manuelaceron/closed-loop-FDM-printer/docs/Sustentacio_Manuela Cerón.pdf

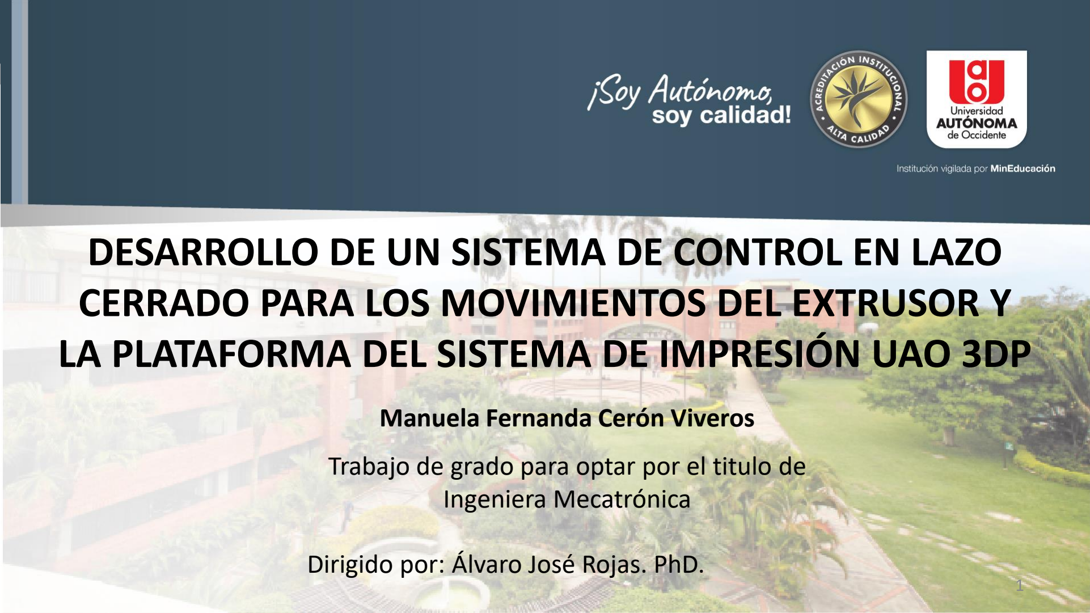
[picture p17: page 1]

# DESARROLLO DE UN SISTEMA DE CONTROL EN LAZO CERRADO PARA LOS MOVIMIENTOS DEL EXTRUSOR Y LA PLATAFORMA DEL SISTEMA DE IMPRESIÓN UAO 3DP

# Manuela Fernanda Cerón Viveros

# Trabajo de grado para optar por el titulo de Ingeniera Mecatrónica

Dirigido por: Álvaro José Rojas. PhD.

# MARCO TEORICO

# › IMPRESIÓN 3D

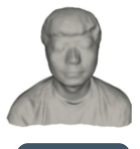
[picture p18: figure]
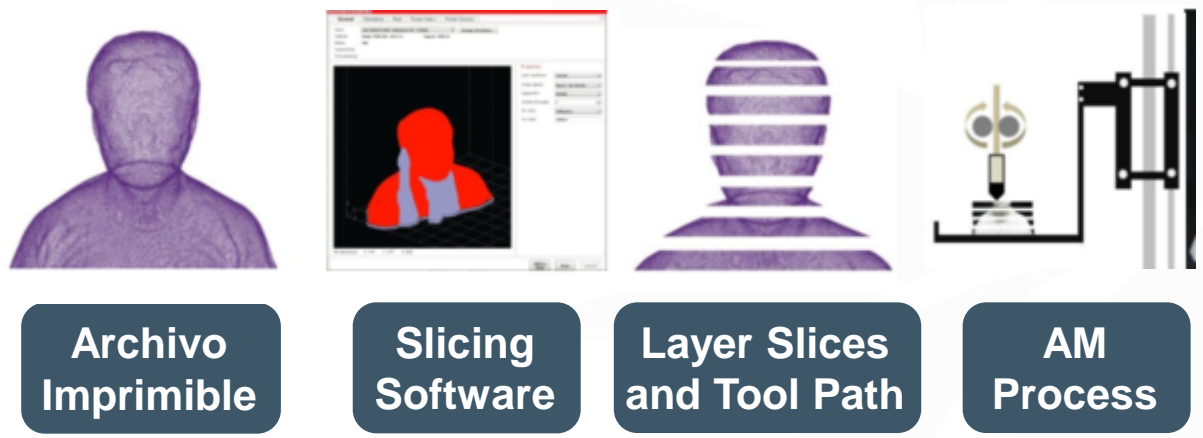
[picture p19: figure]
Slicing Software; Layer Slices and Tool Path; AM Process; Archivo Imprimible

## 3D CAD Model

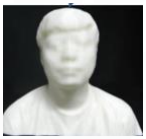
[picture p20: figure]

## Physical 3D Object

Fotopolimerización | Extrusión de material

# Fusión de cama de polvo

# › TECNOLOGÍAS DE IMPRESIÓN 3D

# Inyección de material Inyección de aglutinante

# Deposición de

energía directa | Laminado

Fuente: REDWOOD, Ben. Additive Manufacturing Technologies: An Overview [En línea]. 3D HUBS. [Consultado el 29 de Marzo del 2018]. Disponible en internet: https://www.3dhubs.com/knowledge-base/additive-manufacturing-technologies-overview

# › SISTEMA DE CONTROL

# Lazo de Control Abierto

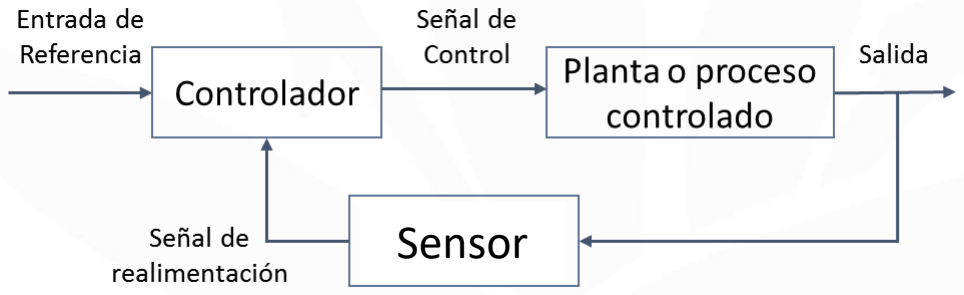
[picture p21: figure]
Sensor

# Lazo de Control Cerrado

# › SENSORES DE POSICIÓN

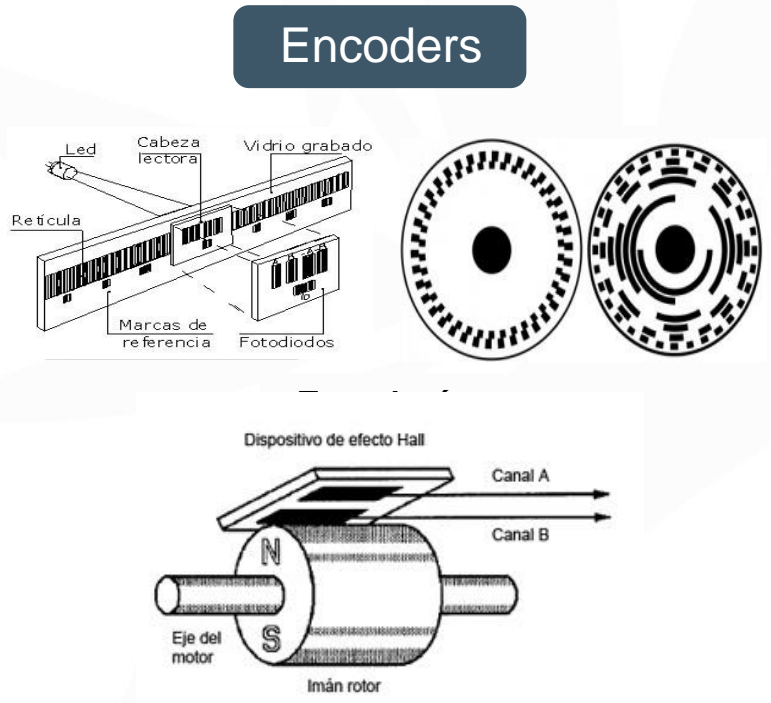
[picture p22: figure]
Arquitectura; › Lineal › Rotacional; Tecnología; › Magnético › Óptico; › Inductivo; Tipo; › Incremental › Absoluto

Resistivos | Inductivos | Encoders

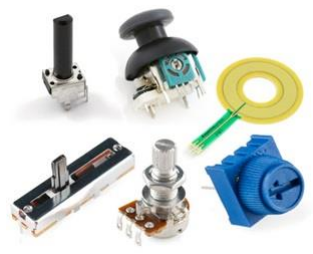
[picture p23: figure]

## › Resolver › LVDT › RVDT

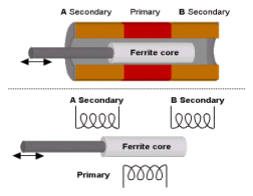
[picture p24: figure]

# › IMPRESORA UAO 3DP

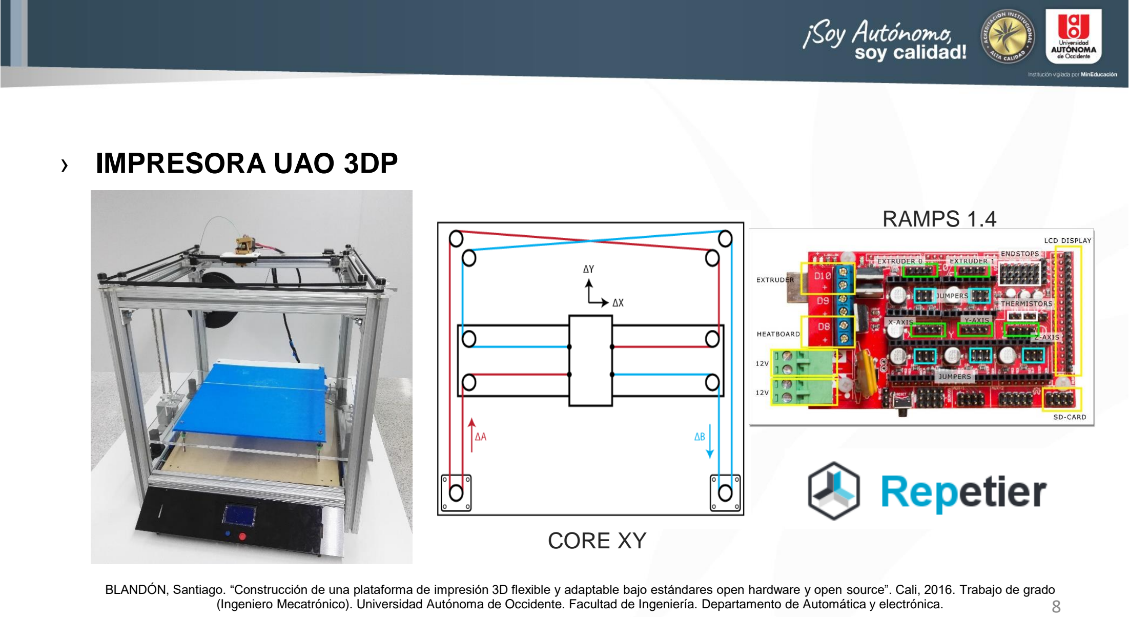
[picture p25: page 6]

BLANDÓN, Santiago. “Construcción de una plataforma de impresión 3D flexible y adaptable bajo estándares open hardware y open source”. Cali, 2016. Trabajo de grado (Ingeniero Mecatrónico). Universidad Autónoma de Occidente. Facultad de Ingeniería. Departamento de Automática y electrónica.

## RAMPS 1.4

## CORE XY

# PLANTEAMIENTO DEL PROBLEMA

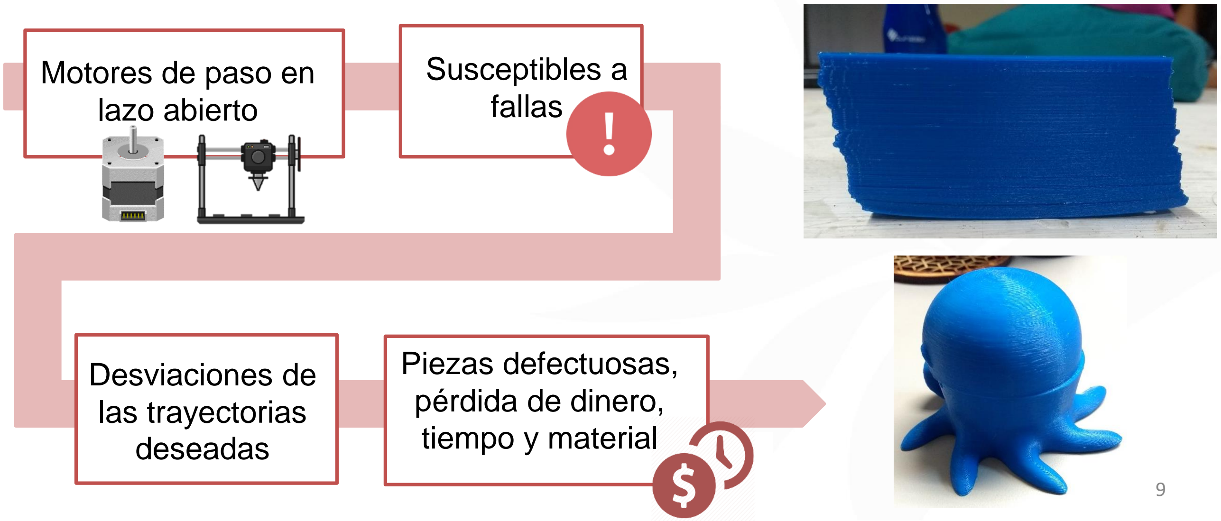
[picture p26: figure]
Desviaciones de las trayectorias deseadas; Piezas defectuosas, pérdida de dinero, tiempo y material; Motores de paso en lazo abierto; Susceptibles a fallas

# OBJETIVO GENERAL

# OBJETIVOS ESPECIFICOS

# Diseñar e implementar un sistema de control de lazo cerrado para los movimientos del extrusor y plataforma de la impresora UAO 3DP, que permita asegurar el

correcto posicionamiento de dichos elementos ante posibles perturbaciones.

## - Instrumentar la impresora UAO 3DP para posibilitar la realimentación de la posición

relativa del cabezal y plataforma de construcción durante el proceso de impresión.

## - Desarrollar un software para el proceso de supervisión de movimiento y detección

de fallos.

## - Integrar el sistema de supervisión de movimiento con el control del proceso de

impresión.

## - Documentar el proceso de diseño del sistema de lazo cerrado para impresoras 3D

y valorar su aplicabilidad en otras técnicas de impresión.

# DESARROLLO

## › DESCOMPOSICIÓN FUNCIONAL

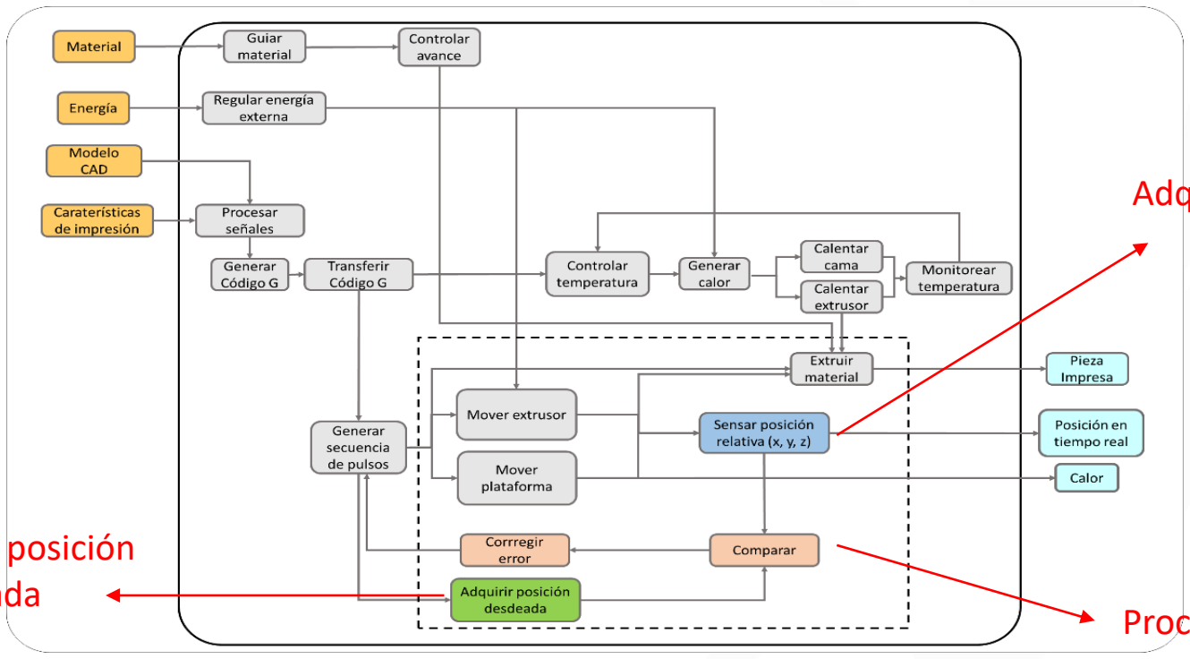
[picture p27: figure]

## Adquisición posición actual

## Adquisición posición deseada Proceso de control

# DESARROLLO

Resolución | 0.005mm (5um/ 5micron)
Precisión | ± 7.5 um
Señal de Salida | 5V, TTL, conector DB9
Tipo de onda de salida | 2 señales de cuadratura
Velocidad | 1.2m/s
Temperatura de operación | 0 – 40°C
Voltaje de trabajo | 5V ± 20%
Longitud de medida disponible | 500mm
Máximo rango de medida | 530mm
Longitud total de la escala | 654mm
Cable de señal | 3.5m
› | SELECCIÓN DEL SENSOR DE POSICIÓN

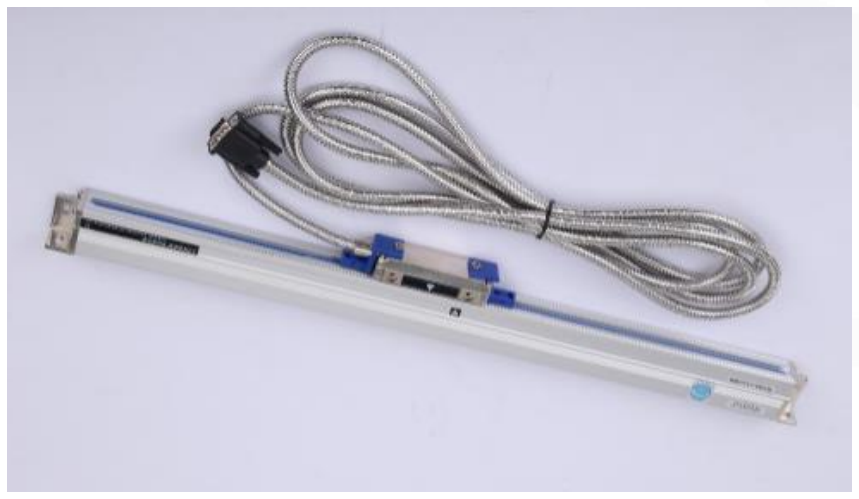
[picture p28: figure]

## Encoder incremental Lineal Óptico WTB 500

# DESARROLLO

## › UBICACIÓN DE LOS SENSORES

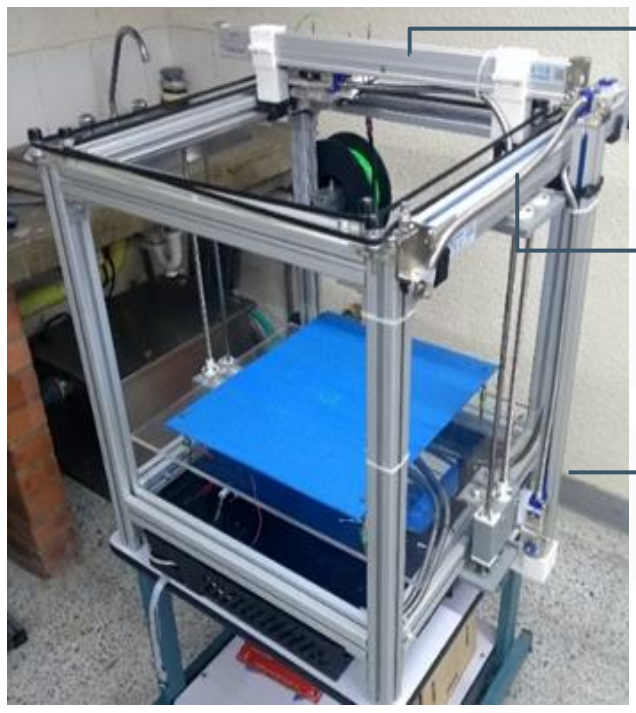
[picture p29: figure]

# Eje X

# Eje Y

# Eje Z

# DESARROLLO

## › Ubicacación Eje X

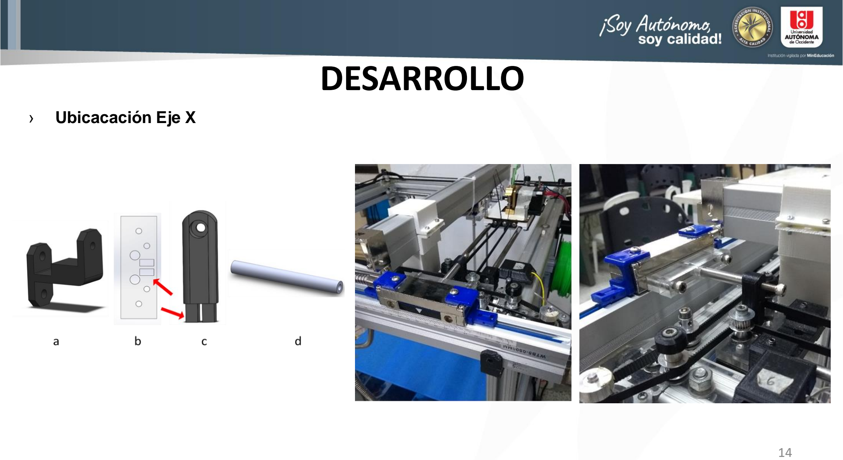
[picture p30: page 12]

# DESARROLLO

## › Ubicación inicial Eje Y

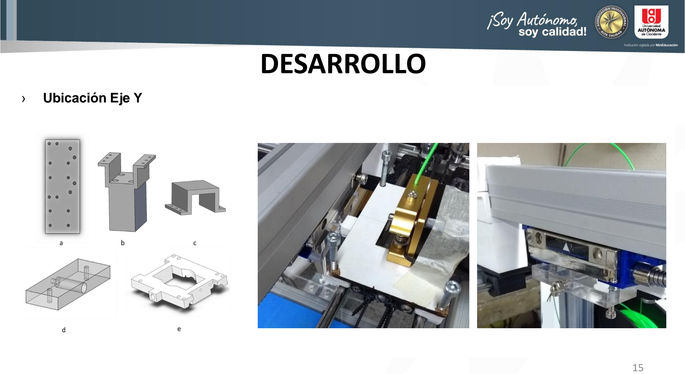
[picture p31: page 13]

## Eje x

## Eje y

## › Ubicación Eje Y

# DESARROLLO

## › Ubicación Eje Z

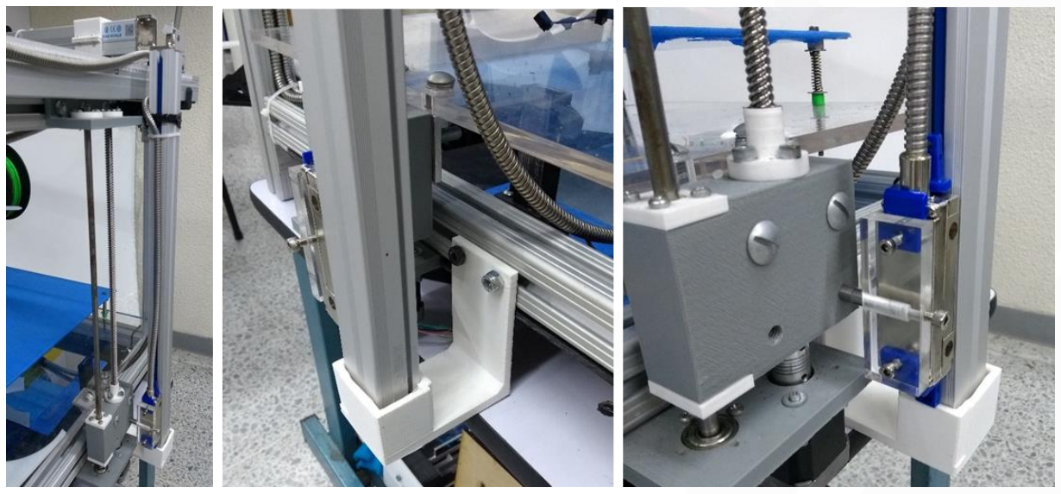
[picture p32: figure]

# DESARROLLO

› | ADQUISICIÓN POSICIÓN ACTUAL | › | ADQUISICIÓN POSICIÓN DESEADA

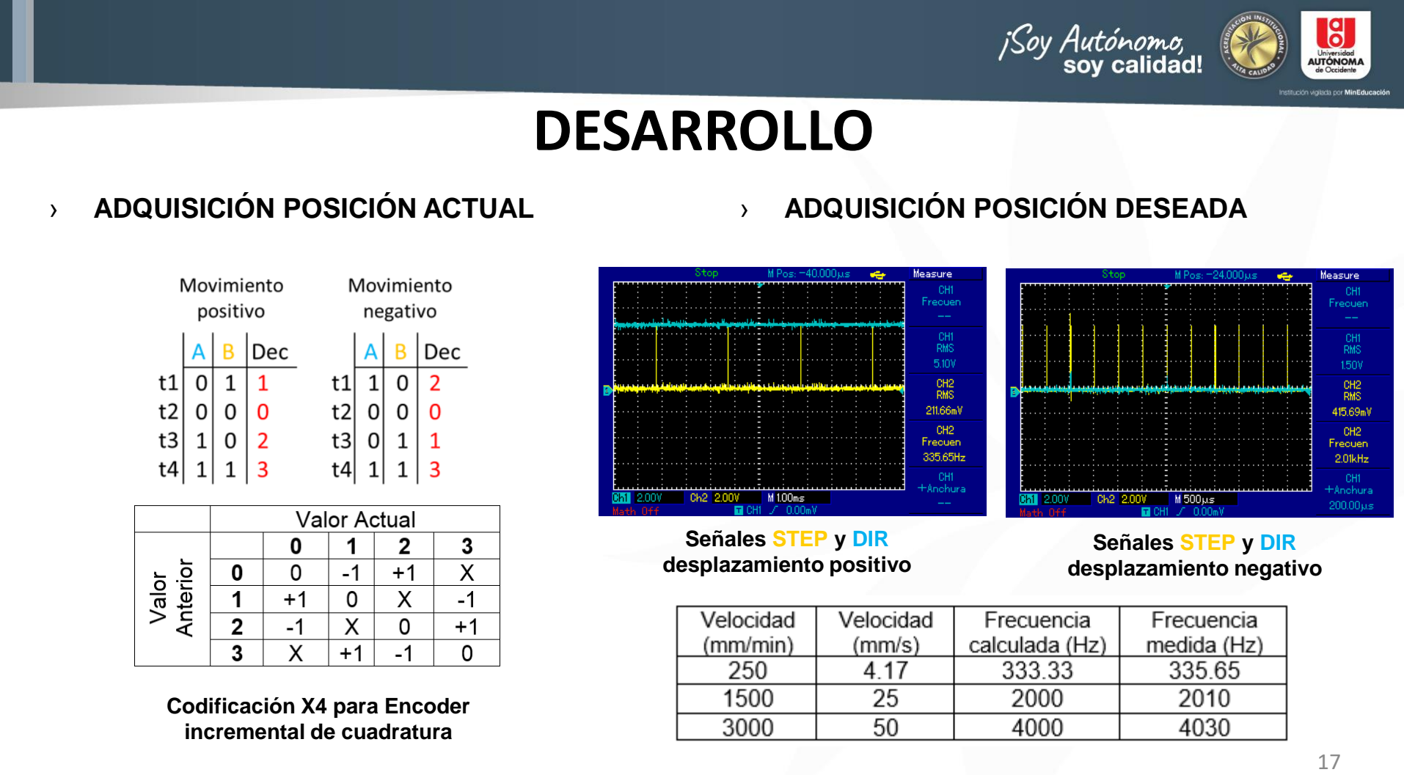
[picture p33: page 15]

Señal encoder canal A y B
desfasados en fase a 90°
Codificación X4 para Encoder incremental de cuadratura

Señales STEP y DIR
desplazamiento positivo

Señales STEP y DIR
desplazamiento negativo

# DESARROLLO

80 µpulsos | 1mm
3200 µpulsos | 40mm

## Movimiento lineal

# Encoder (x,y) = 8000 pulsos

| rev

# FR(x,y)= 80 µpulsos

mm

# FR(z)= 252 µpulsos

mm

## Elementos mecánicos UAO 3DP

# RAMPS (x,y)= 200 pulsos

## rev

# 1pulso = 1.8°

# RAMPS (x,y)= 3200 µpulsos

## rev

# 1µpulso = 0.1125°

### Resolución RAMPS 1

16

## Configuración motores NEMA 17

# DESARROLLO

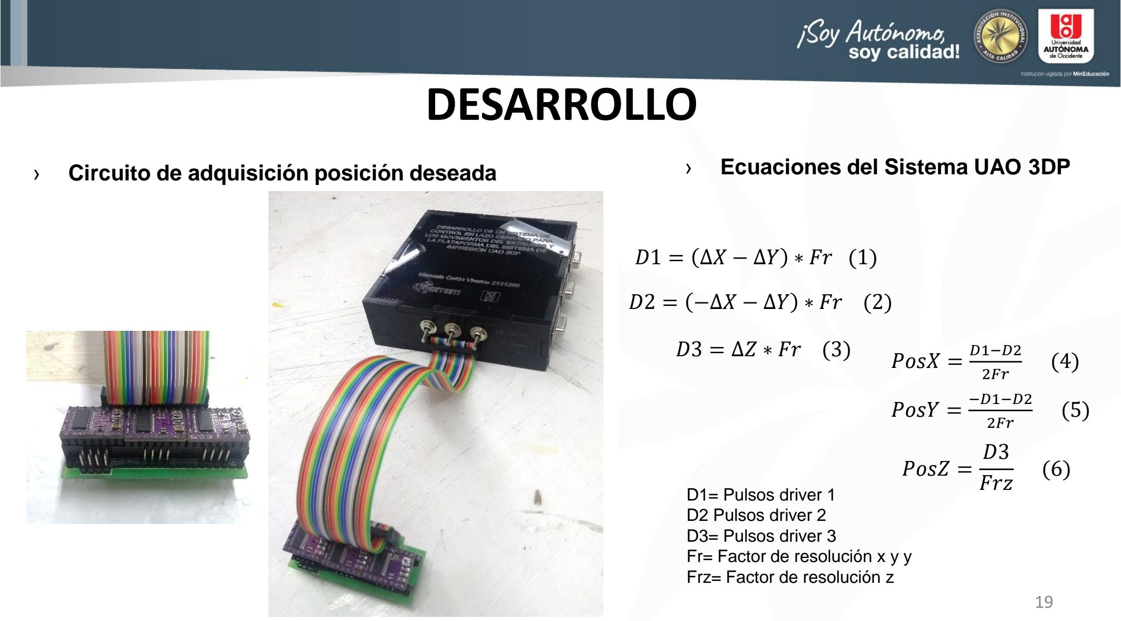
[picture p34: page 17]

Esquema general del circuito de adqusición de posición desdeada desde controlador RAMPS

## D1 = ∆X − ∆Y ∗ Fr (1)

## D2 = −∆X − ∆Y ∗ Fr (2)

## D3 = ∆Z ∗ Fr (3) PosX =

D1−D2
2Fr

(4)

## PosY =

−D1−D2
2Fr

(5)

## PosZ =

D3

## Frz (6)

D1= Pulsos driver 1
D2 Pulsos driver 2
D3= Pulsos driver 3
Fr= Factor de resolución x y y Frz= Factor de resolución z
› | Circuito de adquisición posición deseada | › | Ecuaciones del Sistema UAO 3DP

# DESARROLLO

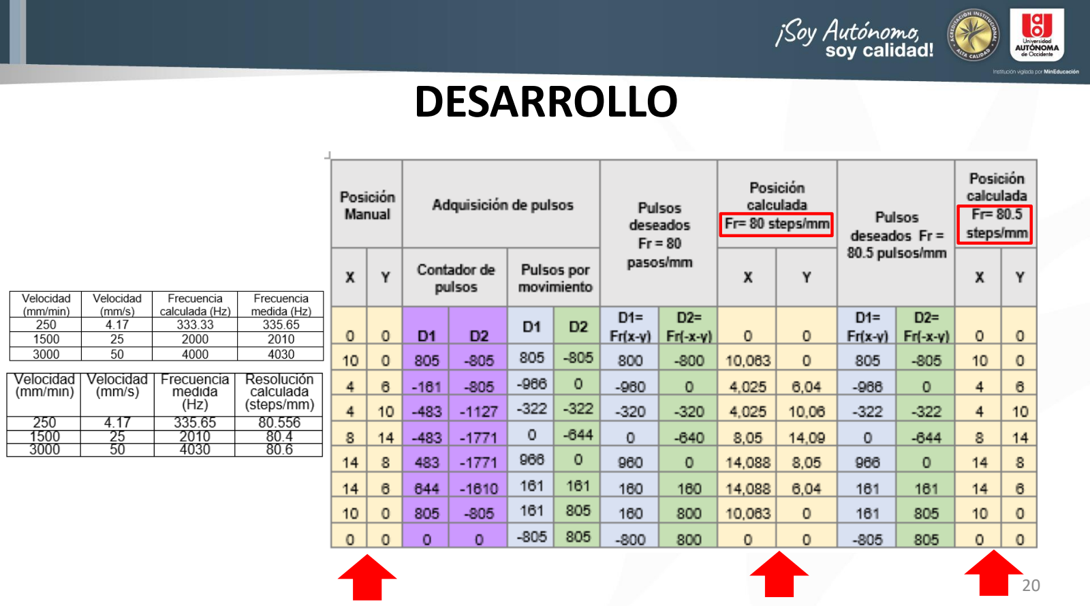
[picture p35: page 18]

# DESARROLLO

## › ESTRATEGIA DE CONTROL

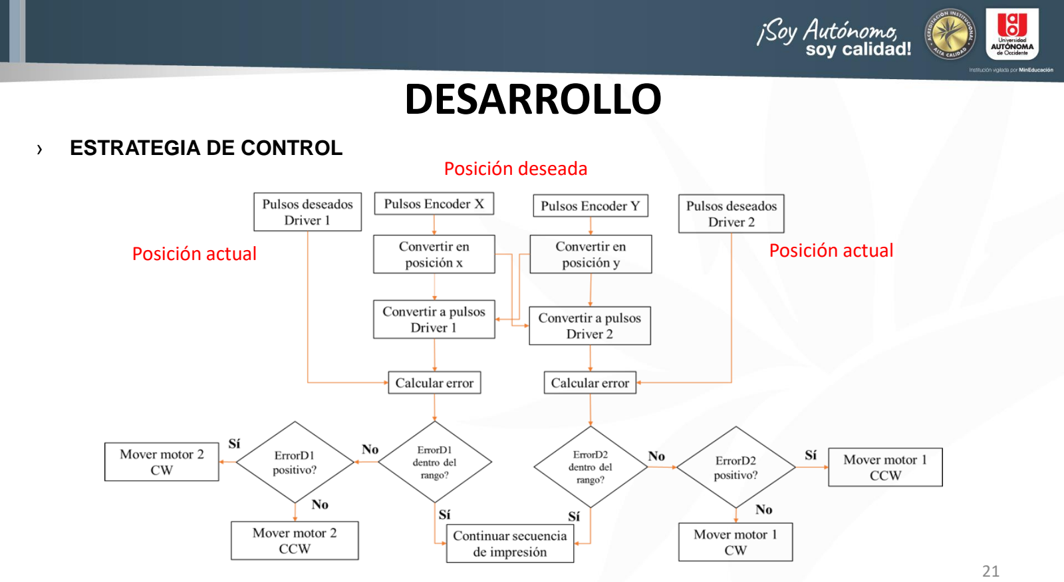
[picture p36: page 19]

## Posición deseada

Posición actual | Posición actual

# DESARROLLO

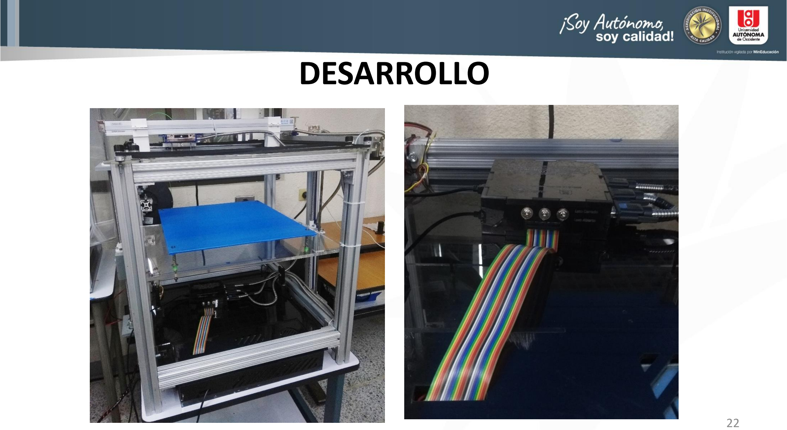
[picture p37: page 20]

# DESARROLLO

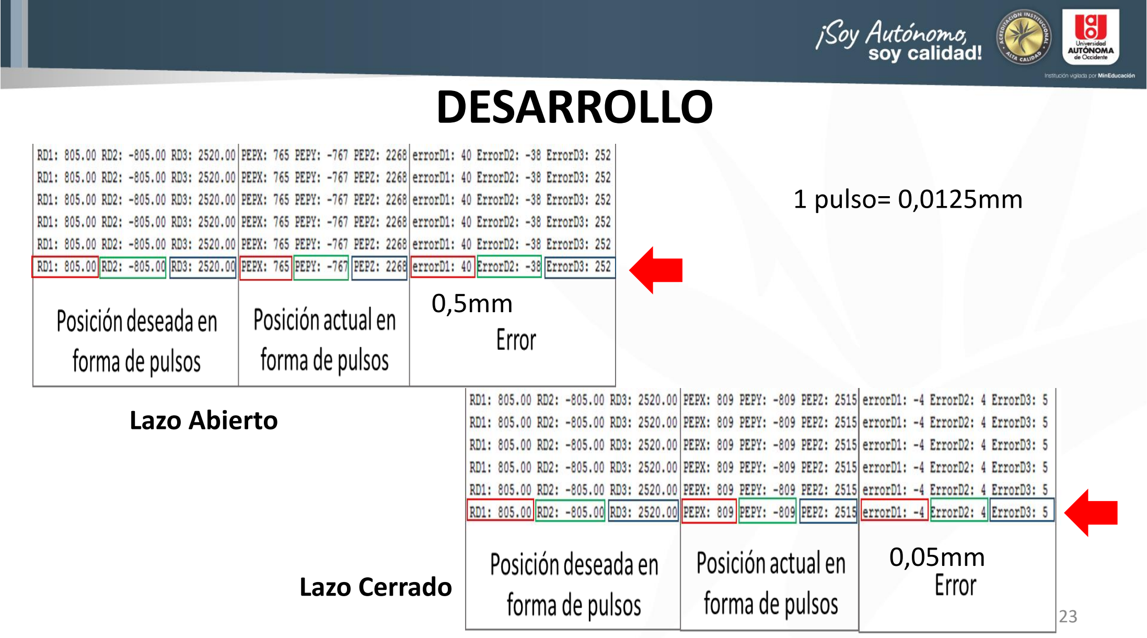
[picture p38: page 21]

# 1 pulso= 0,0125mm

0,05mm

0,5mm

# Lazo Abierto

# Lazo Cerrado

# PRUEBAS DE VALIDACIÓN

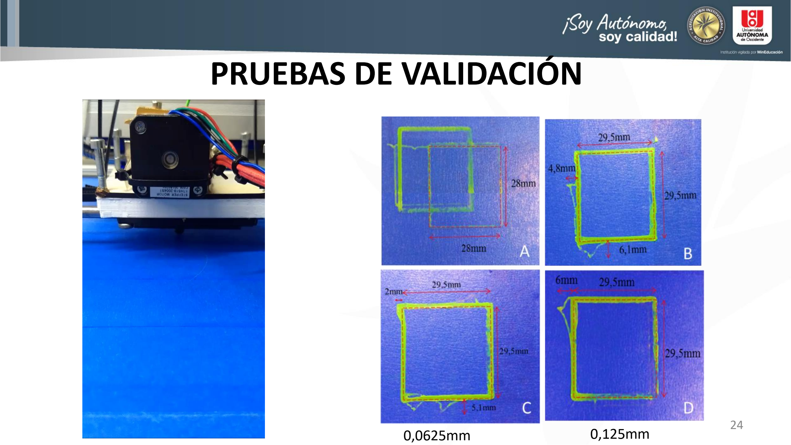
[picture p39: page 22]

0,0625mm | 0,125mm | 24

# PRUEBAS DE VALIDACIÓN

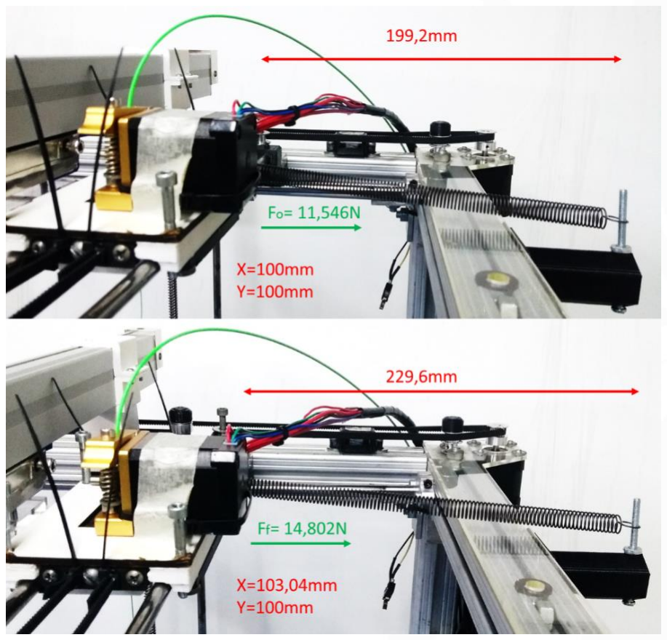
[picture p40: figure]

## › PRUEBA CUANTITATIVA

# PRUEBAS DE VALIDACIÓN

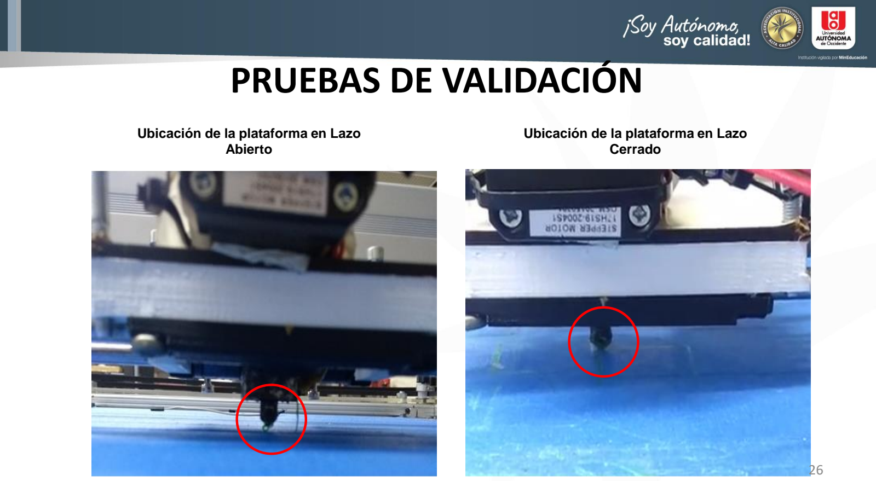
[picture p41: page 24]

Ubicación de la plataforma en Lazo Abierto

Ubicación de la plataforma en Lazo Cerrado

# RESULTADOS

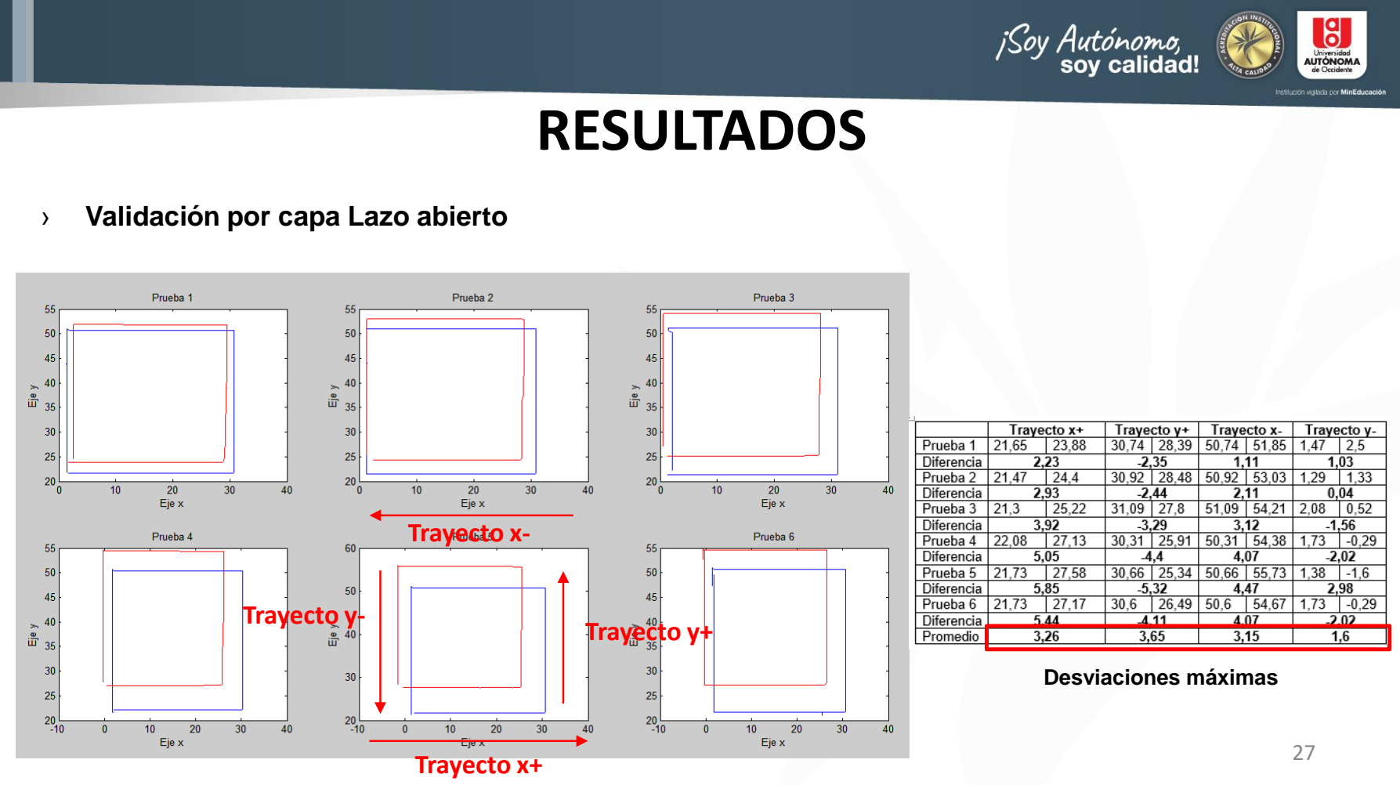
[picture p42: page 25]

## Trayecto x+

## Trayecto x-

## Trayecto y+

## Trayecto y-

## › Validación por capa Lazo abierto

Desviaciones máximas

# PRUEBAS DE VALIDACIÓN

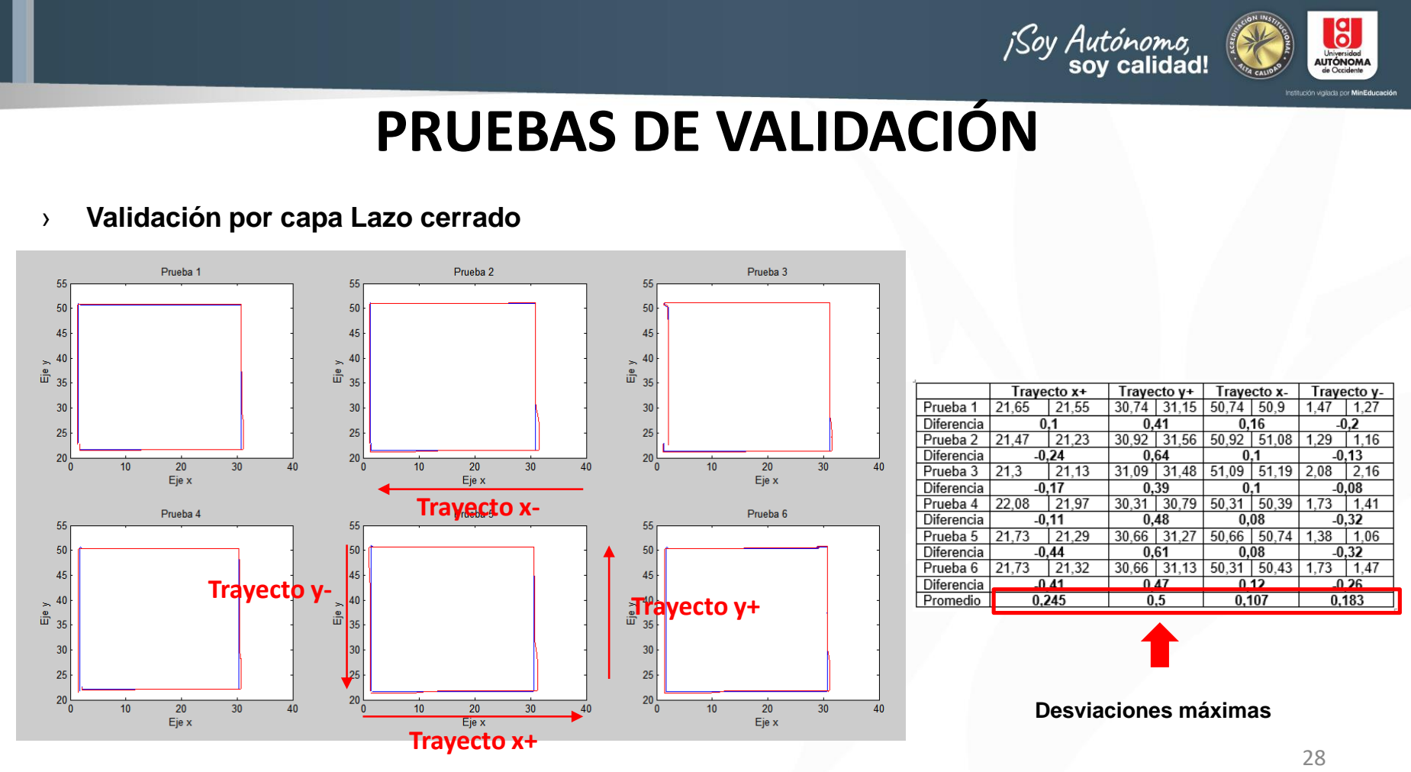
[picture p43: page 26]

## › Validación por capa Lazo cerrado

## Trayecto x+

## Trayecto x-

## Trayecto y+

## Trayecto y-

Desviaciones máximas

# PRUEBAS DE VALIDACIÓN

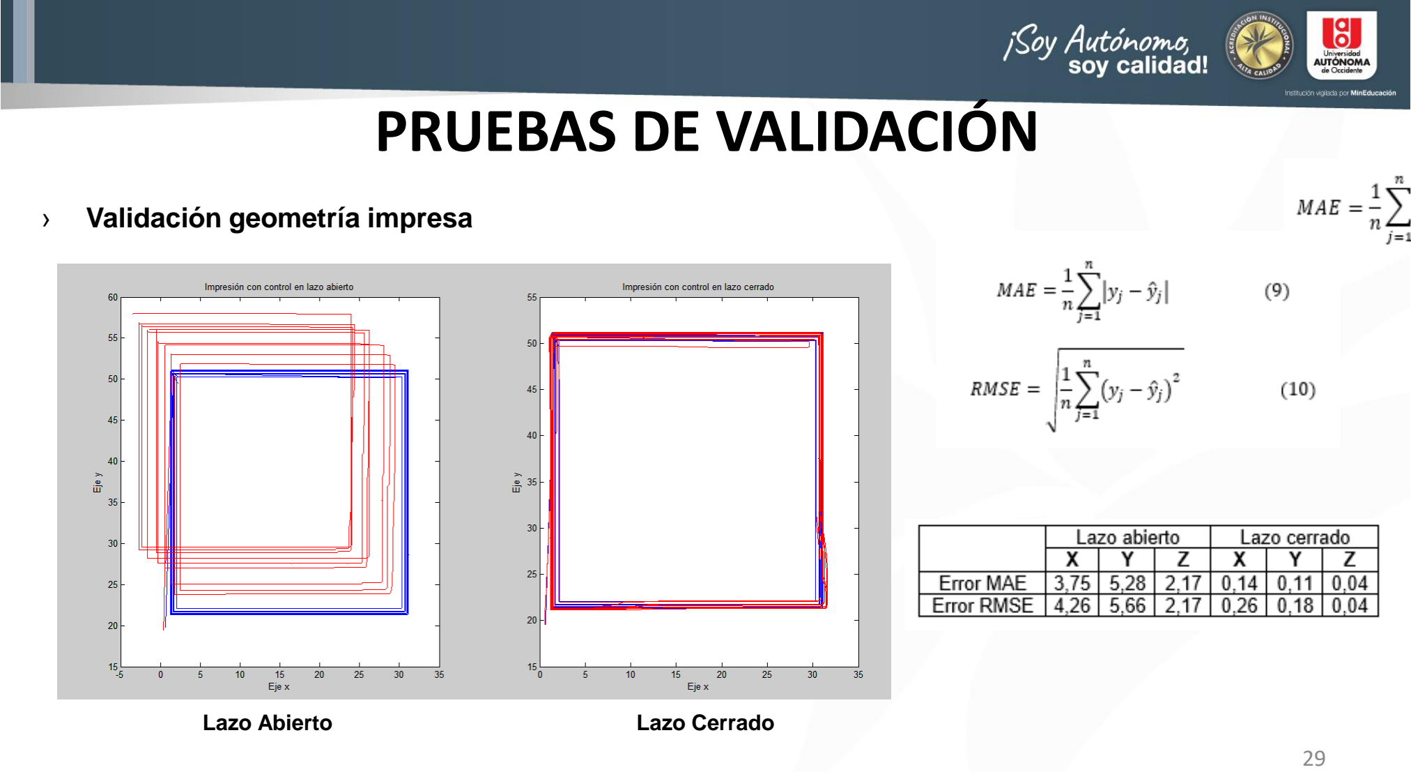
[picture p44: page 27]

› | Validación geometría impresa
Lazo Abierto | Lazo Cerrado

# CONCLUSIONES

- El sistema monitorea la posición del cabezal y la plataforma durante el proceso de impresión y corrige la desviación de la trayectoria ante perturbaciones.
- La impresora UAO 3DP fue instrumentada con sensores de posición para realimentar la posición relativa del cabezal y plataforma de construcción durante el proceso de impresión, la integración de estos fue uno de los desafíos del proyecto.
- Las características open hardware y open source de la impresora UAO 3DP permitieron integrar el sistema de control de posición al sistema de control de impresión.
- El software de control de posición se desarrolló con el microcontrolador Atmega 2560 y la plataforma Arduino, para leer y procesar las señales de los sensores y de la RAMPS, y generar la acción de control durante el proceso de impresión.
- Sin mencionar la tecnología por procesamiento de Luz Directa (DLP), el sistema de control puede aplicarse a las demás técnicas de impresión o máquinas de mecanizado CNC que tienen sistemas de posicionamiento en 3 ejes.

# RECOMENDACIONES TRABAJO A FUTURO

- El sistema de control de posición puede mejorarse si se realiza una modificación del Firmware que controla la impresora, o si éste se desarrolla desde cero.
- Para la impresora UAO 3DP se recomienda la integración del sistema desarrollado en este proyecto con otras técnicas para cerrar completamente el lazo de control en el proceso de impresión 3D, como el sistema de supervisión de extrusión de filamento; buscando obtener sistemas mucho más robustos y confiables.
- Un trabajo a futuro para mejorar el desempeño de la impresora UAO 3DP y que puede aplicarse a sistemas de impresión open-source, corresponde al desarrollo de una técnica para lograr la reanudación del proceso de impresión tras una desconexión o pérdida de la fuente de alimentación de la impresora.

# REFERENCIAS

3D PRINTING. What is 3d printing? [En línea]. [Consultado el 14 de marzo de 2017] Disponible en internet: https://3dprinting.com/what-is-3dprinting/#whatitis (https://3dprinting.com/what-is-3d-printing/#whatitis)

ACARNLEY, Paul. Stepping Motors a guide to theory and practice. 4ta edición. The Institution of Engineering and Technology. 2007. London, United Kingdom.

AMAYA, Juan; ROJAS, Álvaro Development of a Supervision System: Towards Closing the Control Loop in 3D Printing Systems” presented at the Printing for fabrication conference, Manchester, UK, 2016

--------, --------. “Diseño de un sistema de supervisión para la extrusión de materiales poliméricos en impresoras 3D de software libre”. Cali, 2017. Trabajo de grado (Ingeniero Mecatrónico). Universidad Autónoma de Occidente. Facultad de Ingeniería. Departamento de Automática y electrónica.

BLANDÓN, Santiago. “Construcción de una plataforma de impresión 3D flexible y adaptable bajo estándares open hardware y open source”. Cali, 2016. Trabajo de grado (Ingeniero Mecatrónico). Universidad Autónoma de Occidente. Facultad de Ingeniería. Departamento de Automática y electrónica.

--------, --------. AMAYA, Juan. ROJAS, Álvaro. "Development of a 3D Printer and a Supervision System Towards the Improvement of Physical Properties and Surface Finish of the Printed Parts," presented at the 2nd Colombian Conference on Automatic Control, Manizales, Colombia, 2015.

BOURELL, Dave, et. Al. Roadmap for Additive Manufacturing Identifying the Future of Freeform Processing. ed. Austin, TX: The University of Texas at Austin, 2009.

# REFERENCIAS

MCKITTRICK B, “Closed-Loop Control of a 3D Printer Gantry”. Trabajo de grado (Master of Science). Universidad de Washington. Programa de Ingeniería Mecánica. Disponible en el catálogo en línea de la biblioteca de la Universidad de Washington: https://digital.lib.washington.edu/researchworks/bitstream/handle/1773/26048/Weiss_washington_0250O_13644.pdf
MOYER.Ilian. Core XY [En línea]. [Consultado el 17 de Febrero del 2018]. Disponible en internet: http://corexy.com/theory.html

National Instruments. Difference between X1, X2, X4, and Two-Pulse Encoder Types [En línea]. (Publicado el 4 de Noviembre del 2008). [Consultado el 17 de Enero del 2017]. Disponible en internet: http://digital.ni.com/public.nsf/allkb/FDFA1FB36C8DD235862574F7006D8E3C

NYCE, David. Linear position sensors: theory and application. John Wiley & Sons, 2004. ISBN 0471474274, 9780471474272

POLOLU. DRV8825 Stepper Motor Driver Carrier, High Current (md20a) [En línea]. [Consultado el 17 de Febrero del 2018] Disponible en internet: https://www.pololu.com/product/2132

SANCHEZ, M. DC motor close-loop control Software [En línea]. [Consultado el 20 de diciembre de 2017] Disponible en internet: https://www.youmagine.com/designs/dc-motor-closed-loop-control-software

SAPIENSMAN Automatización Industrial. Control de motores. Sensores de retroalimentación de servosistemas. [En línea]. [Consultado en línea el 18 de marzo del 2017]. Disponible en: http://www.sapiensman.com/tecnoficio/electricidad/velocidad_de_motores_electricos5.php

ULRICH, K; EPPINGER, S. Diseño | y | Desarrollo | de | Productos. 2004. Edición 3. McGraw-Hill: México
